vvk4/Vector-S/Doc/TOP_VectorS_rus.jpg

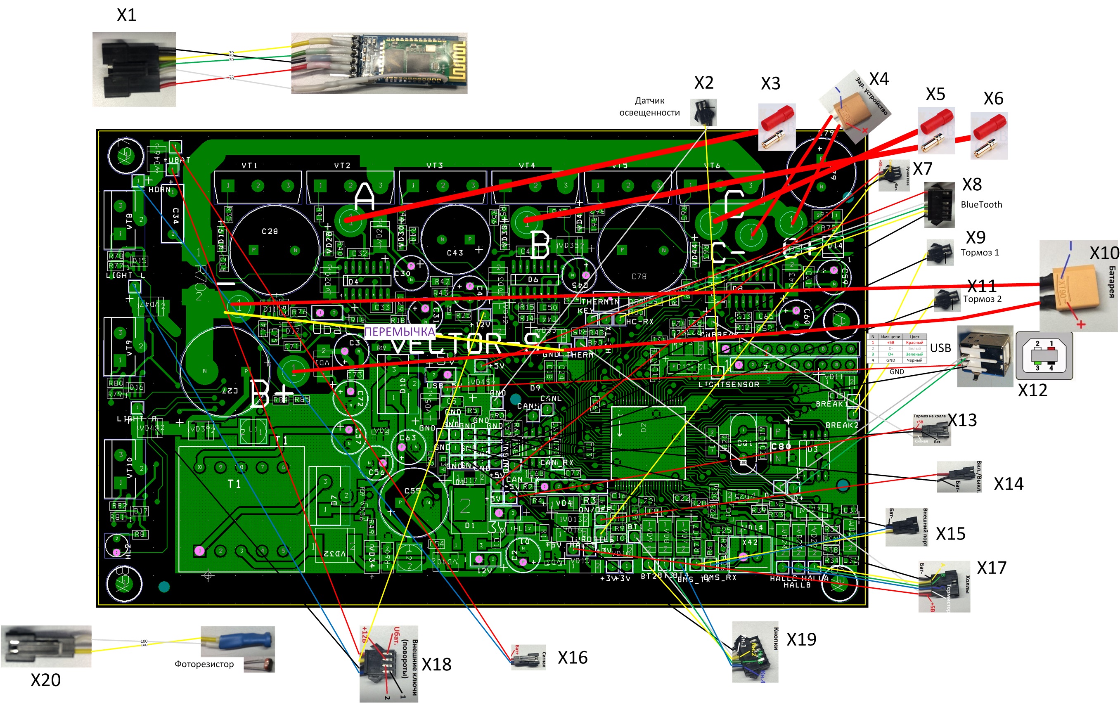
Doc/TOP_VectorS_rus.jpg
