vvk4/Vector-S/Doc/BottomVectorSMirrored.jpg

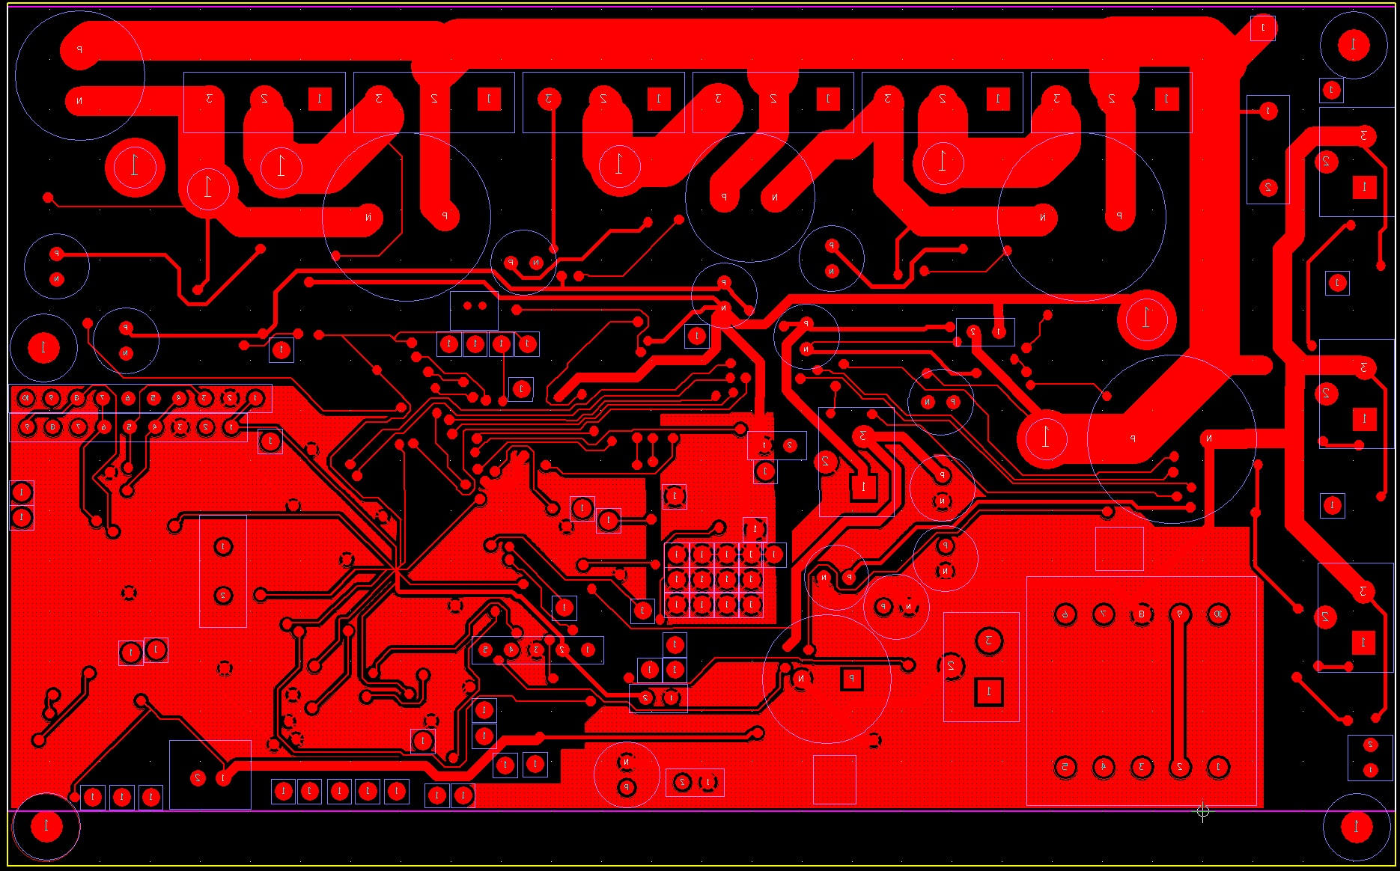
Doc/BottomVectorSMirrored.jpg
