vvk4/Vector-S/Doc/BOM_VectorS_SMD.xlsx

Sheet: Sheet1
 |  |  | PCS BOM
Item # | *Ref Des | *Qty | Manufacturer | *Mfg Part # | Description / Value | *Package | Type | Your Instructions / Notes
1 | D2 | 1 | Microchip | dsPIC33EP512MU810-I/PF | IC dsPIC33 MCU | 100-Lead TQFP (14x14x1 mm) | SMD
2 | D11 | 1 | Texas Instruments | INA181A1IDBV | Current-Sense Amplifier | SOT-23 (6) | SMD
3 | D4,D6,D8 | 3 | Infineon Technologies | IRS21864S | High and Low Side Driver IC | 14 Lead SOIC | SMD | 160.72
4 | D15,D16,D17 | 3 | Infineon Technologies | IRS44273L | Low Side Driver IC | 5 Lead SOT23 | SMD | 50.83
5 | D1 | 1 | ST Microelectronics | LF33CDT | voltage regulator | DPAK | SMD
6 | D14 | 1 | LITEON | LTV-356T | optocoupler | 4 Lead SOIC | SMD
7 | D12 | 1 | Texas Instruments | REF1933AIDDC | Voltage References | SOT-23 (5) | SMD
8 | D3 | 1 | Microchip | SST25VF016B-50-4C-S2AF | IC 16 Mbit SPI Serial Flash | 8-Lead SOIC | SMD
9 | C23,C62,C73,C1,C4,C6,C7,C8,C9,C10,C11,C13,C14,C15,C16,C20,C22,C48,C52,C54,C69,C71,C74,C75,C76,C77 | 26 | Murata | GRM188R71H104K | CAP 0.1UF X7R 16V 10% | 0603 | SMD | 40
10 | C5 | 1 | Murata | GRM21BR71E225K | CAP 2.2UF X7R 16V 10% | 0805 | SMD
11 | C35,C36,C37 | 3 | Murata | GRM188R71H222K | CAP 2200PF X7R 50V 10% | 0603 | SMD | 12
12 | C17 | 1 | Murata | GRM319R71H104K | CAP 0.1UF X7R 50V 10% | 1206 | SMD
13 | C19,C21 | 2 | Murata | GRM1885C1H220J | CAP 22PF NP0 50V 10% | 0603 | SMD
14 | C18,C24,C25,C29,C32,C33,C39,C44,C47,C50,C58,C61,C65 | 13 | Murata | GRM21BR71H105K | CAP 1UF X7R 50V 10% | 0805 | SMD
15 | C80 | 1 | Vishay | 293D476X96R3B2TE3 | CAP 47UF 6.3V Tantalum B size | B size | SMD | 1
16 | C12 | 1 | Kemet | T491A106K006AT | CAP 10UF 6.3V Tantalum A size | A size | SMD
17 | R4,R1,R8 | 3 | Yageo | RC0603FR-07470RL | RES 470 OHM 1% 0603 | 0603 | SMD
18 | R2,R49 | 2 | Yageo | RC0603FR-07100RL | RES 100 OHM 1% 0603 | 0603 | SMD
19 | R3,R11,R12,R13,R14,R15,R16,R18,R24,R31,R76,R77,R79,R81,R30 | 15 | Yageo | RC0603FR-0710KL | RES 10K OHM 1% 0603 | 0603 | SMD
20 | R37,R38,R39,R75,R5,R28 | 6 | Yageo | RC0603FR-07680RL | RES 680 OHM 1% 0603 | 0603 | SMD
21 | R6,R7,R9,R23 | 4 | Yageo | RC0603FR-076K2L | RES 6.2K OHM 1% 0603 | 0603 | SMD
22 | R26 | 1 | Yageo | RC0603FR-072K7L | RES 2.7K OHM 1% 0603 | 0603 | SMD
23 | R33,R34,R36,R25,R27,R29,R43,R54,R73 | 9 | Yageo | RC0603FR-073K3L | RES 3.3K OHM 1% 0603 | 0603 | SMD
24 | R42,R47,R69 | 3 | Yageo | RC0805FR-07100KL | RES 100K OHM 1% 0805 | 0805 | SMD
25 | R45,R55 | 2 | Yageo | RC0603FR-072K2L | RES 2.2K OHM 1% 0603 | 0603 | SMD
26 | R48,R58 | 2 | Yageo | RC0603FR-075K1L | RES 5.1K OHM 1% 0603 | 0603 | SMD
27 | R19 | 1 | Yageo | RC0603FR-071K5L | RES 1.5K OHM 1% 0603 | 0603 | SMD
28 | R32,R40,R44,R56,R61,R63 | 6 | Yageo | RC0603FR-0710RL | RES 10 OHM 1% 0603 | 0603 | SMD
29 | R78,R80,R82 | 3 | Yageo | RC0603FR-0720RL | RES 20 OHM 1% 0603 | 0603 | SMD
30 | R59 | 1 | Yageo | RC0603FR-074R7L | RES 4.7 OHM 1% 0603 | 0603 | SMD
31 | R17 | 1 | Yageo | RC0603FR-0747KL | RES 47K OHM 1% 0603 | 0603 | SMD
32 | R71,R72 | 2 | Yageo | RC1206FR-075K1L | RES 20K OHM 1% 1206 | 1206 | SMD | 9
33 | R35,R41,R46,R57,R62,R65 | 6 | Yageo | RC0603FR-075R6L | RES 5.6 OHM 1% 0603 | 0603 | SMD
34 | R60 | 1 | Yageo | RC1206FR-07820RL | RES 820 OHM 1% 1206 | 1206 | SMD
35 | R22 | 1 | Yageo | RC0805FR-0712KL | RES 12K OHM 1% 0603 | 0805 | SMD
36 | R20 | 1 | Yageo | RC0603FR-071ML | RES 1m OHM 1% 0603 | 0603 | SMD
37 | R70 | 1 | BOURNS | CSS2H-3920R-L200F | Current sens resistor 0.0002 OHM |  | SMD
38 | VD1,VD5 | 2 | Vishay | VS-10BQ040-M3/5BT | Schottky Rectifier, 40V, 1.0 A | SMB | SMD
39 | VD3 | 1 | DC Components | BZX84C3V6 | Zener 3.6V | sot23 | SMD
40 | VD25,VD26,VD27,VD19,VD28,VD30,VD38,VD41,VD44,VD4,VD14,VD34 | 12 | Vishay | LL4148-GS08 | Fast Switching Diode | SOD-80 | SMD
41 | VD7,VD8,VD9,VD10,VD11,VD12,VD13,VD15,VD16,VD17,VD18,VD22,VD23,VD24,VD33 | 15 | ST Microelectronics | TMMBAT46FILM | Schottky Rectifier, 100V, 150 mA | MiniMELF | SMD | 4.72
42 | VD2 | 1 | DC Components | MMBZ5V6ALT1G | Zener Suppressors | sot23 | SMD
43 | VD20,VD31,VD39,VD42,VD45,VD46,VD47,VD48 | 8 | ON Semiconductor | MURS120T3G | Power Rectifiers | SMB | SMD | 8.5
44 | VD21,VD35,VD40,VD43 | 4 | ST Microelectronics | SM6T15A | Power supressor 15V | SMB | SMD | 8.37
45 | VD36 | 1 | DC Components | BZX84C5V1 | Zener 5.1V | sot23 | SMD
46 | VD32 | 1 | Vishay | 30BQ100-M3 | Schottky Rectifier, 100V, 3.0 A | SMB | SMD
47 | HL1 | 1 | ParaLight | L-C150KGCT | LED | 1206 | SMD
48 | L1,L2 | 2 | BOURNS | SDR0503-270ML | Chip coil 27uH | 0503 | SMD
49 | Q1 | 1 | Fairchild Semiconductor | 2N7002 | N-channel transistor | sot23 | SMD

Sheet: Sheet2
RES 680 OHM 1% 0603 | 20
RES 3.3K OHM 1% 0603 | 30
RES 10 OHM 1% 0603 | 20
RES 4.7 OHM 1% 0603 | 5
RES 20K OHM 1% 1206 | 10
VS-10BQ040-M3/5BT | 6
MMBZ5V6ALT1G | 3
MURS120T3G | 25
10U X100V | 3
CD288H 470U X 100V | 6
CD288H 47U X 16V | 24
