vvk4/Vector-S/Doc/SCH_VectorS.pdf

# CE# SOWP#

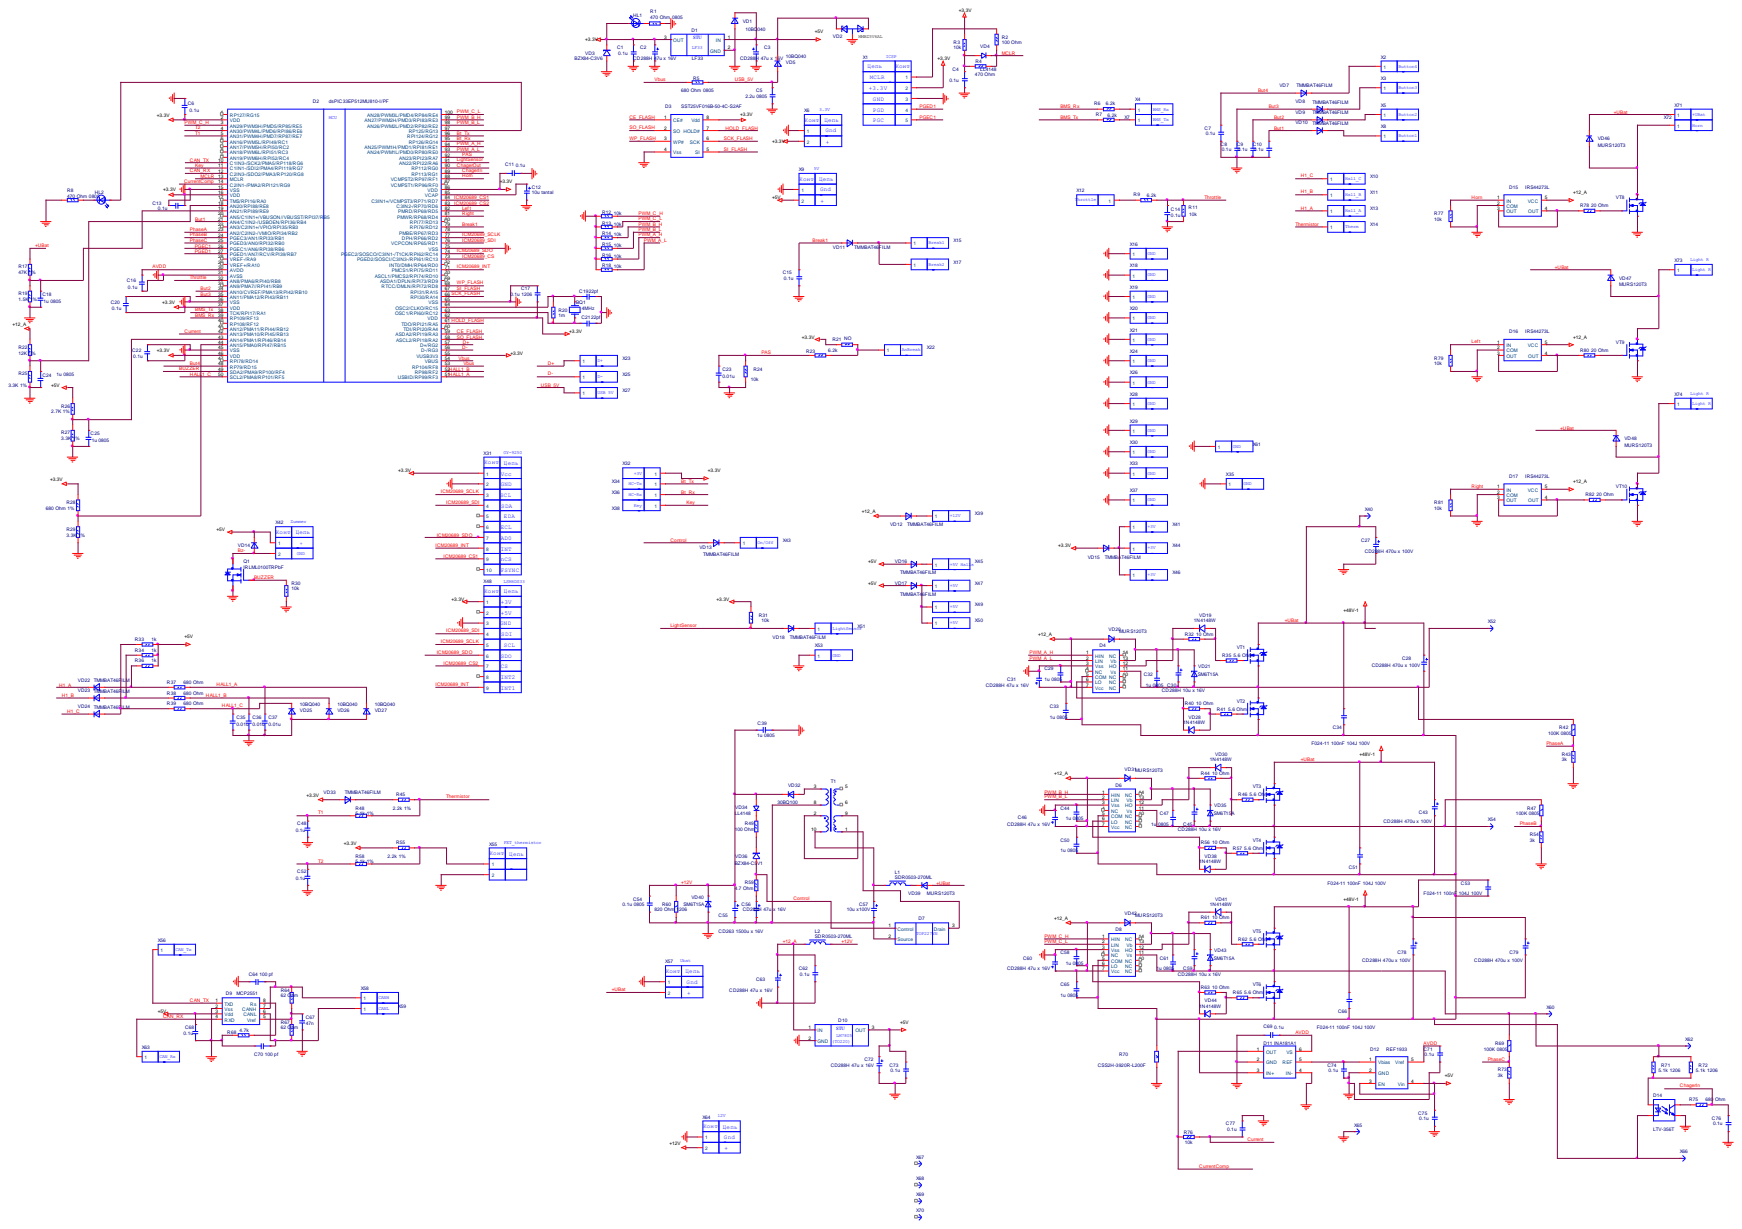
[picture p3: page 1]

VCPCON/RP65/RD1 DPH/RP66/RD2 PMBE/RP67/RD3 RPI76/RD12 RPI77/RD13 PMWR/RP68/RD4 PMRD/RP69/RD5 C3IN2-/RP70/RD6 C3IN1+/VCMPST3/RP71/RD7 VCAP

INT0/DMH/RP64/RD0 PGED2/SOSCI/C3IN3-/RPI61/RC13 PGEC2/SOSCO/C3IN1-/T1CK/RPI62/RC14 VSS

VUSB3V3 D-/RG3 D+/RG2 ASCL2/RPI18/RA2 ASDA2/RPI19/RA3 TDI/RPI20/RA4 TDO/RPI21/RA5 VDD OSC1/RPI60/RC12 OSC2/CLKO/RC15 VSS RPI30/RA14 RPI31/RA15 RTCC/DMLN/RPI72/RD8 ASDA1/DPLN/RPI73/RD9 ASCL1/PMCS2/RPI74/RD10 PMCS1/RPI75/RD11

Конт | Цепь

1 | Gnd
