vvk4/Vector-S/Doc/CompTOP_SMD.pdf

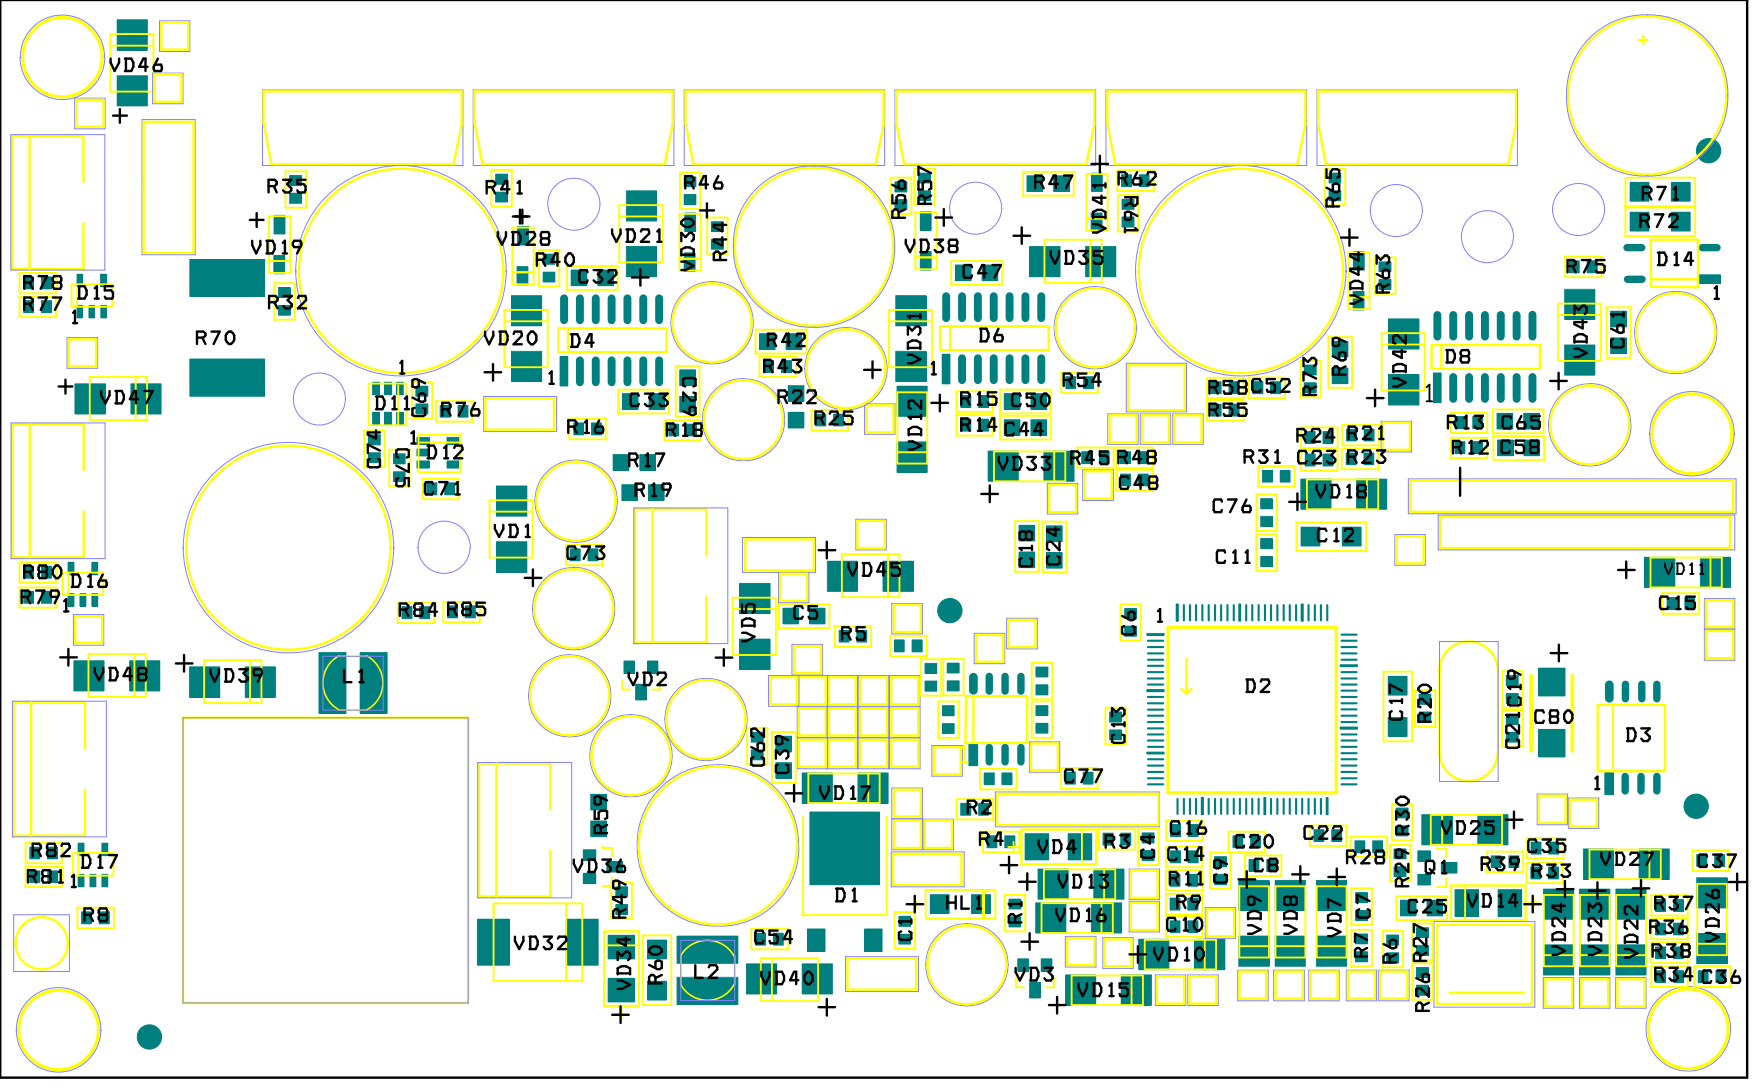
[picture p4: page 1]
