vvk4/Vector-S/(list of files, drawings)

Other design files:
SCH_PCB/X1.DSN
SCH_PCB/x1.opj
