vvk4/Vector-S/X1.X/Thermistors.c

#include "Mn.h"

const unsigned int Tenzo1[24] = {
    T1_V1,
    T1_V2,
    T1_V3,
    T1_V4,
    T1_V5,
    T1_V6,
    T1_V7,
    T1_V8,
    T1_V9,
    T1_V10,
    T1_V11,
    T1_V12,
    T1_V13,
    T1_V14,
    T1_V15,
    T1_V16,
    T1_V17,
    T1_V18,
    T1_V19,
    T1_V20,
    T1_V21,
    T1_V22,
    T1_V23,
    T1_V24};

const int TempTenzo1[24] = {
    -55,
    -50,
    -40,
    -30,
    -20,
    -10,
    0,
    10,
    20,
    25,
    30,
    40,
    50, 60, 70, 80, 90, 100, 110, 120, 125, 130, 140, 150
};



const unsigned int Tenzo2[34] = {T2_V1,
    T2_V2,
    T2_V3,
    T2_V4,
    T2_V5,
    T2_V6,
    T2_V7,
    T2_V8,
    T2_V9,
    T2_V10,
    T2_V11,
    T2_V12,
    T2_V13,
    T2_V14,
    T2_V15,
    T2_V16,
    T2_V17,
    T2_V18,
    T2_V19,
    T2_V20,
    T2_V21,
    T2_V22,
    T2_V23,
    T2_V24,
    T2_V25,
    T2_V26,
    T2_V27,
    T2_V28,
    T2_V29,
    T2_V30,
    T2_V31,
    T2_V32,
    T2_V33,
    T2_V34};

const int TempTenzo2[34] = {
    -40,
    -35,
    -30,
    -25,
    -20,
    -15,
    -10,
    -5,
    0,
    5,
    10,
    15,
    20,
    25,
    30,
    35,
    40,
    45,
    50,
    55,
    60,
    65,
    70,
    75,
    80,
    85,
    90,
    95,
    100,
    105,
    110,
    115,
    120,
    125
};

const unsigned int Tenzo7[29] = {
    T7_V1,
    T7_V2,
    T7_V3,
    T7_V4,
    T7_V5,
    T7_V6,
    T7_V7,
    T7_V8,
    T7_V9,
    T7_V10,
    T7_V11,
    T7_V12,
    T7_V13,
    T7_V14,
    T7_V15,
    T7_V16,
    T7_V17,
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

    if (k >= sz)
        return (float) 150;

    if (k == 0)
        return (float) - 55;

    T = Tenzo4[k] - Tenzo4[k - 1];
    T1 = ResTemp - Tenzo4[k - 1];

    temp = TempTenzo4[k] - TempTenzo4[k - 1];


    T1 = (T1 * temp) / T;

    T = TempTenzo4[k - 1] + T1;



    return T;
}
